jorge-pais/FEUP-IM_projetoFinal/templateRelatorio/IMG_6292.JPG

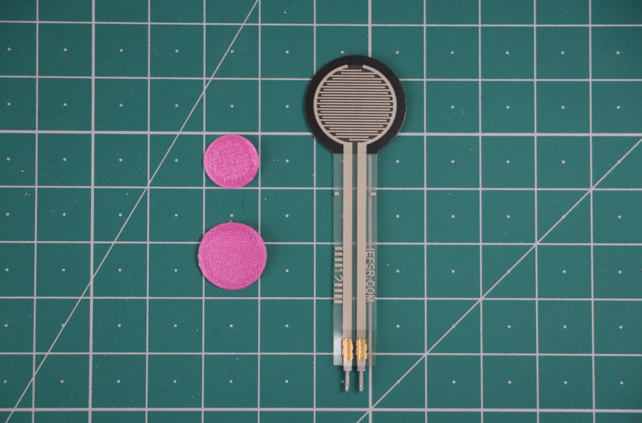
templateRelatorio/IMG_6292.JPG
