jorge-pais/FEUP-IM_projetoFinal/labview/olderversions.md

These files were created targeting LabView 21.0. 
To use older versions, you can do File->Save for Previous Version...
