jorge-pais/FEUP-IM_projetoFinal/templateRelatorio/Untitled1.png

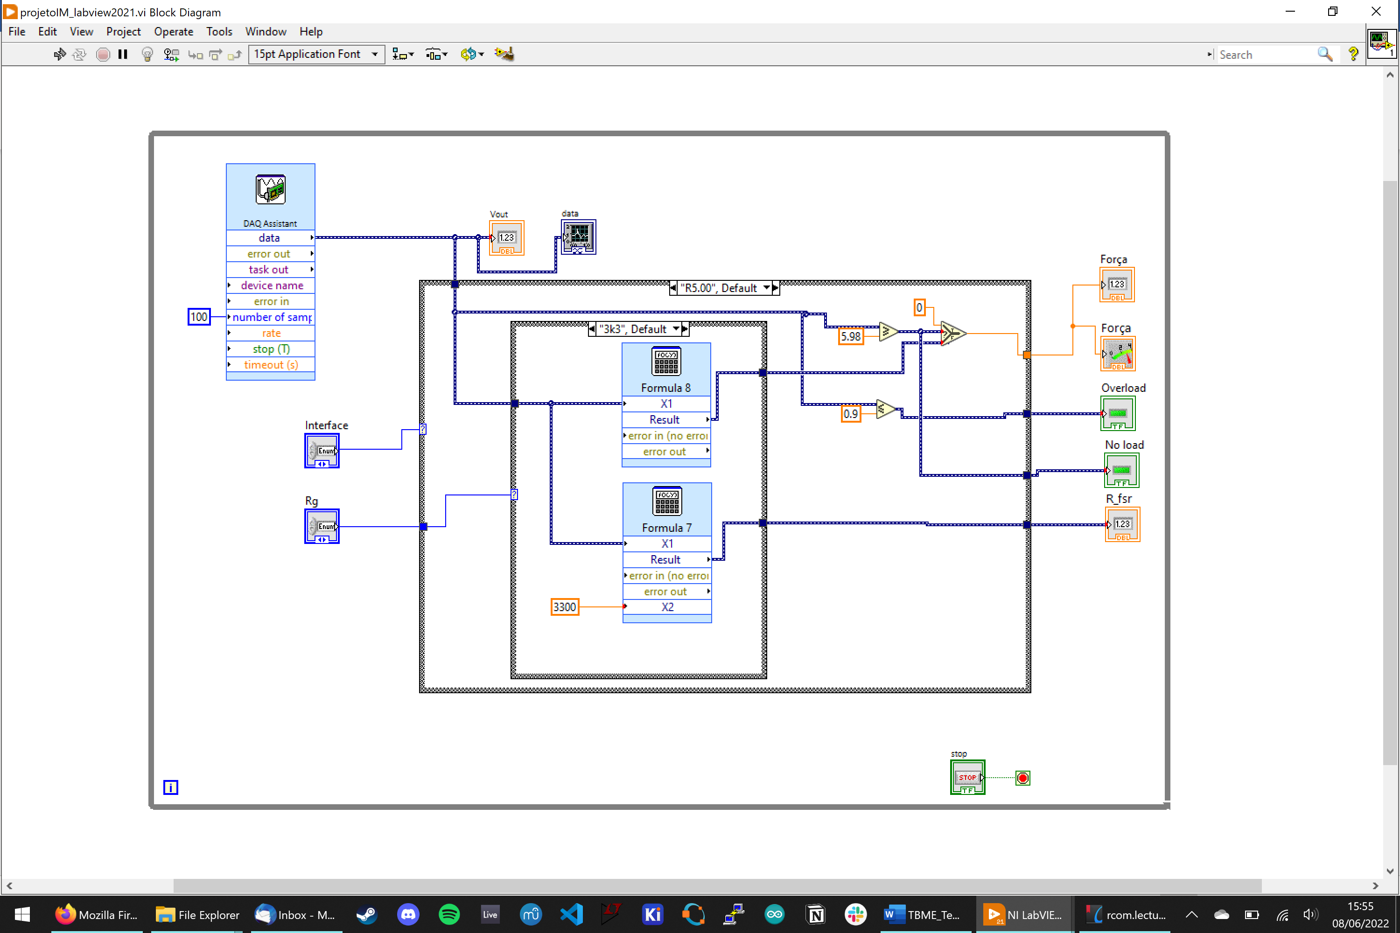
templateRelatorio/Untitled1.png
