jorge-pais/FEUP-IM_projetoFinal/templateRelatorio/Untitled.png

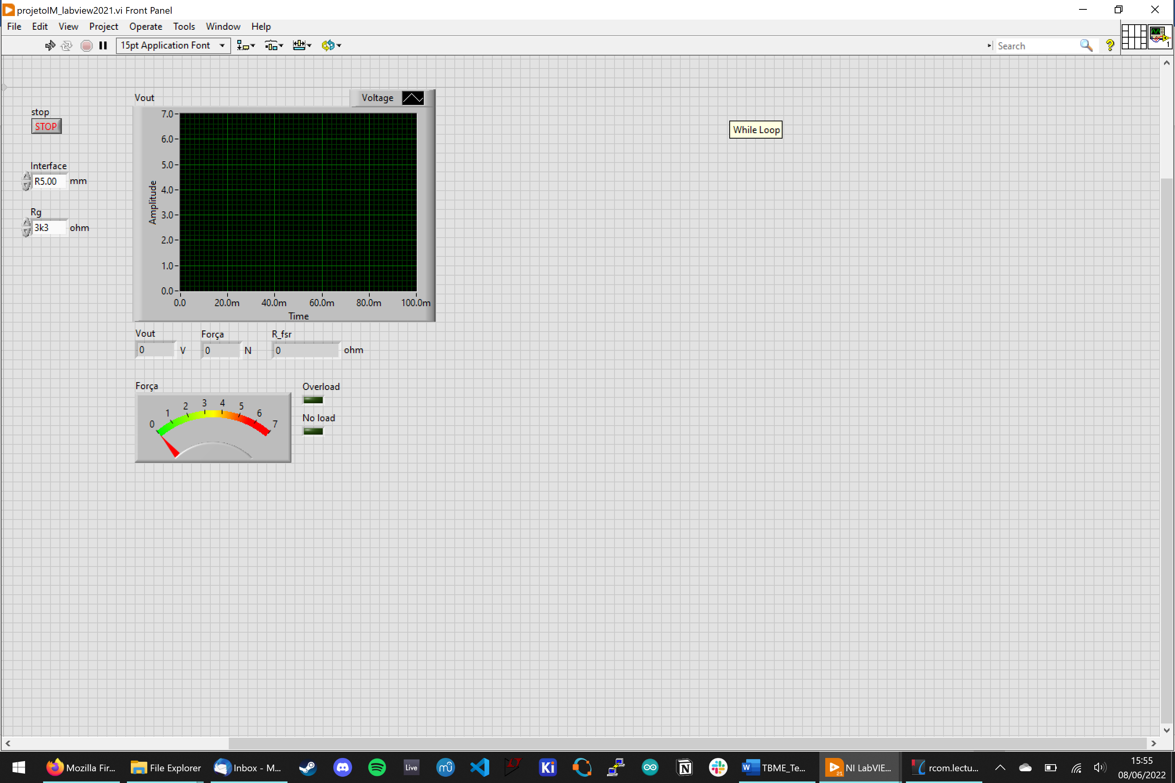
templateRelatorio/Untitled.png
