jorge-pais/FEUP-IM_projetoFinal/3dprint/44-29103-FSR 402.STEP

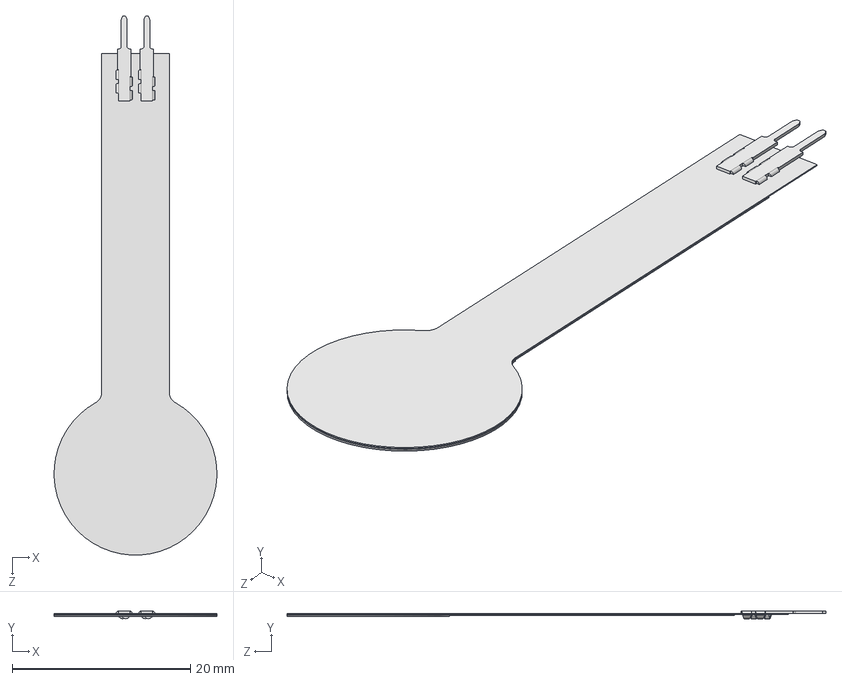
[picture p11: CAD file, 2022-06-08]
3dprint/44-29103-FSR 402.STEP
18.3 x 0.845 x 60.5 mm
30-81794-Semi Substrate
30-81794-Conductor
30-81794-Gusset
30-81794-Semi
30-81794-Rear Adhesive
30-81794-Spacer
SolderTab x 2
30-81794-Cond-Substrate
