jorge-pais/FEUP-IM_projetoFinal/3dprint/circle.FCStd

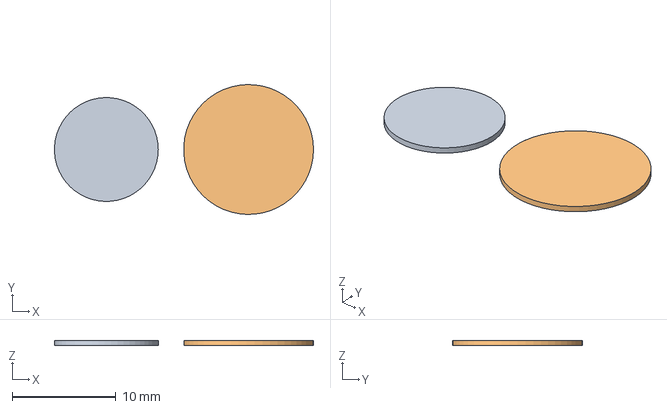
[picture p12: CAD file, 2022-06-08]
3dprint/circle.FCStd
24.9 x 12.5 x 0.5 mm
