jorge-pais/FEUP-IM_projetoFinal/3dprint/support.FCStd

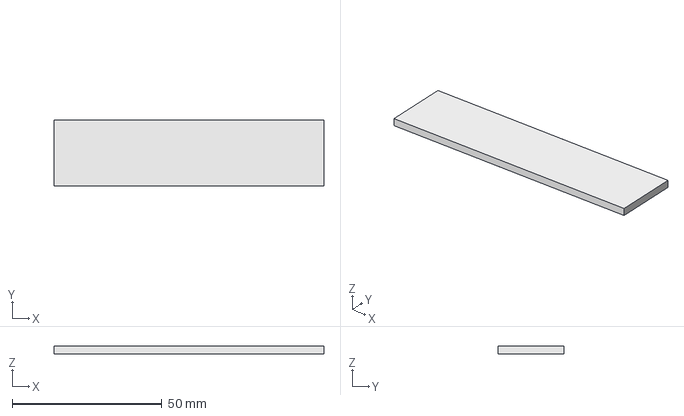
[picture p13: CAD file, 2022-06-08]
3dprint/support.FCStd
90.0 x 22.0 x 2.50 mm
