jorge-pais/FEUP-IM_projetoFinal/(list of files, cad)

Other CAD files:
3dprint/interface.stl
