jorge-pais/FEUP-IM_projetoFinal/Calibração.ods

Borracha1 | Raio | Area |  | Rg |  | Vref
 | 5.00E-03 | 7.85E-05 |  | 3.30E+03 |  | 1.20E+01
Massa (g) | Peso (N) | Pressão (Pa) | Vout1 (V) up | Vout2 (V) down | Average Vout | R_fsr (ohm)
20 | 0.2 | 2546.473135 | 5.98 | 5.98 | 5.98 | 9.90E+05
40 | 0.4 | 5092.946269 | 5.61 | 5.57 | 5.59 | 4.83E+04
50 | 0.5 | 6366.182837 | 5.36 | 5.4 | 5.38 | 3.19E+04
60 | 0.6 | 7639.419404 | 5.14 | 4.96 | 5.05 | 2.08E+04
70 | 0.7 | 8912.655971 | 4.88 | 4.8 | 4.84 | 1.71E+04
100 | 1 | 12732.36567 | 3.67 | 3.97 | 3.82 | 9.08E+03
120 | 1.2 | 15278.83881 | 3.52 | 3.51 | 3.515 | 7.97E+03
150 | 1.5 | 19098.54851 | 2.52 | 2.63 | 2.575 | 5.78E+03
200 | 2 | 25464.73135 | 1.16 | 1.26 | 1.21 | 4.13E+03
250 | 2.5 | 31830.91418 | 0.76 | 0.76 | 0.76 | 3.78E+03
300 | 3 | 38197.09702 | 0.76 | 0.76 | 0.76 | 3.78E+03
Borracha1 | Raio | Area |  | Rg |  | Vref
 | 5.00E-03 | 7.85E-05 |  | 1.50E+03 |  | 1.20E+01
Massa (g) | Peso (N) | Pressão (Pa) | Vout1 (V) up | Vout2 (V) down | Average Vout | R_fsr (ohm)
20 | 0.2 | 2546.473135 | 5.99 | 6 | 5.995 | 1.80E+06
40 | 0.4 | 5092.946269 | 5.78 | 5.78 | 5.78 | 9.00E+04
50 | 0.5 | 6366.182837 | 5.67 | 5.7 | 5.685 | 6.29E+04
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
