jorge-pais/FEUP-IM_projetoFinal/(commit log)

2022-06-08 removed endnote files
    [Calibração.ods]
2022-06-09 before evaluation
    [Calibração.ods]
